GabrielFlau132/nightmare-grimm-esp32-led-robot/Models/bravo-Feliz.png

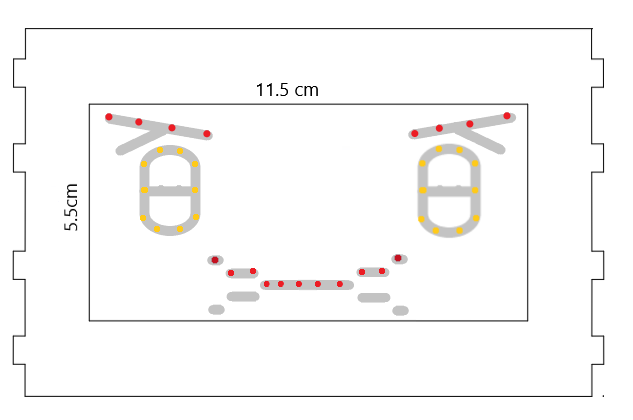
Models/bravo-Feliz.png
