GabrielFlau132/nightmare-grimm-esp32-led-robot/docs/leds.csv

led | grupo | nome_grupo | cor | pino_esp32 | resistor_do_pino_ohm | x_mm | y_mm
L01 | 1 | OLHOS_ANEL | amarelo | 25 | 100 | 14.75 | 16.00
L02 | 1 | OLHOS_ANEL | amarelo | 25 | 100 | 20.25 | 16.00
L03 | 1 | OLHOS_ANEL | amarelo | 13 | 100 | 94.75 | 16.00
L04 | 1 | OLHOS_ANEL | amarelo | 13 | 100 | 100.25 | 16.00
L05 | 1 | OLHOS_ANEL | amarelo | 25 | 100 | 9.25 | 19.25
L06 | 1 | OLHOS_ANEL | amarelo | 25 | 100 | 25.75 | 19.25
L07 | 1 | OLHOS_ANEL | amarelo | 13 | 100 | 89.25 | 19.25
L08 | 1 | OLHOS_ANEL | amarelo | 13 | 100 | 105.75 | 19.25
L09 | 1 | OLHOS_ANEL | amarelo | 25 | 100 | 9.25 | 31.75
L10 | 1 | OLHOS_ANEL | amarelo | 25 | 100 | 25.75 | 31.75
L11 | 1 | OLHOS_ANEL | amarelo | 13 | 100 | 89.25 | 31.75
L12 | 1 | OLHOS_ANEL | amarelo | 13 | 100 | 105.75 | 31.75
L13 | 1 | OLHOS_ANEL | amarelo | 25 | 100 | 14.75 | 35.00
L14 | 1 | OLHOS_ANEL | amarelo | 25 | 100 | 20.25 | 35.00
L15 | 1 | OLHOS_ANEL | amarelo | 13 | 100 | 94.75 | 35.00
L16 | 1 | OLHOS_ANEL | amarelo | 13 | 100 | 100.25 | 35.00
L17 | 2 | OLHOS_MEIO_LATERAL | amarelo | 26 | 200 | 9.25 | 25.50
L18 | 2 | OLHOS_MEIO_LATERAL | amarelo | 26 | 200 | 25.75 | 25.50
L19 | 2 | OLHOS_MEIO_LATERAL | amarelo | 26 | 200 | 89.25 | 25.50
L20 | 2 | OLHOS_MEIO_LATERAL | amarelo | 26 | 200 | 105.75 | 25.50
L21 | 3 | OLHOS_MEIO_CENTRO | amarelo | 27 | 200 | 14.75 | 25.50
L22 | 3 | OLHOS_MEIO_CENTRO | amarelo | 27 | 200 | 20.25 | 25.50
L23 | 3 | OLHOS_MEIO_CENTRO | amarelo | 27 | 200 | 94.75 | 25.50
L24 | 3 | OLHOS_MEIO_CENTRO | amarelo | 27 | 200 | 100.25 | 25.50
L25 | 4 | SOBRANCELHAS_BRAVAS | vermelho | 32 | 100 | 9.25 | 3.50
L26 | 4 | SOBRANCELHAS_BRAVAS | vermelho | 32 | 100 | 105.75 | 3.50
L27 | 4 | SOBRANCELHAS_BRAVAS | vermelho | 32 | 100 | 14.75 | 5.50
L28 | 4 | SOBRANCELHAS_BRAVAS | vermelho | 32 | 100 | 100.25 | 5.50
L29 | 4 | SOBRANCELHAS_BRAVAS | vermelho | 32 | 100 | 20.25 | 7.50
L30 | 4 | SOBRANCELHAS_BRAVAS | vermelho | 32 | 100 | 94.75 | 7.50
L31 | 4 | SOBRANCELHAS_BRAVAS | vermelho | 32 | 100 | 25.75 | 9.50
L32 | 4 | SOBRANCELHAS_BRAVAS | vermelho | 32 | 100 | 89.25 | 9.50
L33 | 5 | SOBRANCELHAS_TRISTES | azul | 33 | 47 | 14.75 | 10.75
L34 | 5 | SOBRANCELHAS_TRISTES | azul | 33 | 47 | 100.25 | 10.75
L35 | 5 | SOBRANCELHAS_TRISTES | azul | 33 | 47 | 9.25 | 12.75
L36 | 5 | SOBRANCELHAS_TRISTES | azul | 33 | 47 | 105.75 | 12.75
L37 | 5 | SOBRANCELHAS_TRISTES | azul | 33 | 47 | 3.75 | 14.75
L38 | 5 | SOBRANCELHAS_TRISTES | azul | 33 | 47 | 111.25 | 14.75
L39 | 6 | BOCA_RETA | vermelho | 23 | 200 | 49.62 | 40.75
L40 | 6 | BOCA_RETA | vermelho | 23 | 200 | 54.88 | 40.75
L41 | 6 | BOCA_RETA | vermelho | 23 | 200 | 60.12 | 40.75
L42 | 6 | BOCA_RETA | vermelho | 23 | 200 | 65.38 | 40.75
L43 | 7 | BOCA_SORRISO | vermelho | 19 | 150 | 34.62 | 35.75
L44 | 7 | BOCA_SORRISO | vermelho | 19 | 150 | 80.38 | 35.75
L45 | 7 | BOCA_SORRISO | vermelho | 19 | 150 | 39.12 | 38.25
L46 | 7 | BOCA_SORRISO | vermelho | 19 | 150 | 44.38 | 38.25
L47 | 7 | BOCA_SORRISO | vermelho | 19 | 150 | 70.62 | 38.25
L48 | 7 | BOCA_SORRISO | vermelho | 19 | 150 | 75.88 | 38.25
L49 | 8 | BOCA_TRISTE | azul | 18 | 47 | 49.62 | 46.00
L50 | 8 | BOCA_TRISTE | azul | 18 | 47 | 54.88 | 46.00
L51 | 8 | BOCA_TRISTE | azul | 4 | 47 | 60.12 | 46.00
L52 | 8 | BOCA_TRISTE | azul | 4 | 47 | 65.38 | 46.00
L53 | 8 | BOCA_TRISTE | azul | 18 | 47 | 39.12 | 48.50
L54 | 8 | BOCA_TRISTE | azul | 18 | 47 | 44.38 | 48.50
L55 | 8 | BOCA_TRISTE | azul | 4 | 47 | 70.62 | 48.50
L56 | 8 | BOCA_TRISTE | azul | 4 | 47 | 75.88 | 48.50
L57 | 8 | BOCA_TRISTE | azul | 18 | 47 | 34.62 | 51.00
L58 | 8 | BOCA_TRISTE | azul | 4 | 47 | 80.38 | 51.00
