GabrielFlau132/nightmare-grimm-esp32-led-robot/code/NightmareGrimm/config.h

// Configuração do Nightmare Grimm: pinos e tempos.
// É aqui que se ajusta o comportamento sem mexer na lógica.
#pragma once
#include <Arduino.h>
#include "expressoes.h"

// ---------------------------------------------------------------------------
// Pinos do ESP32 (ver grupos_led.h)
// ---------------------------------------------------------------------------
// Os LEDs são ligados direto nos pinos, sem driver: pino -> resistor -> anodo,
// catodo no GND (comum a todos). Cada pino fica com no máximo 8 LEDs (~16 mA),
// por isso os grupos grandes usam 2 pinos: o primeiro liga a metade esquerda
// do rosto (vista de frente) e o segundo, a metade direita.
//
// Escolhidos entre as saídas seguras do ESP32 DevKit: ficam de fora os pinos
// de boot (0, 2, 5, 12, 15), os da memória flash (6–11), os que só funcionam
// como entrada (34–39), a serial USB (1, 3) e o 14 (oscila no boot).
// 21 e 22 ficam livres para I2C.
constexpr uint8_t SEM_PINO = 0xFF;
constexpr uint8_t MAX_PINOS_POR_GRUPO = 2;

constexpr uint8_t PINOS_OLHOS_ANEL[MAX_PINOS_POR_GRUPO]           = { 25, 13 };
// Fios laranja (26) e amarelo (27) retirados: esses grupos só serviam para a
// barra da piscada (ver PISCADA_APAGA_OLHOS). Os pinos continuam reservados.
constexpr uint8_t PINOS_OLHOS_MEIO_LATERAL[MAX_PINOS_POR_GRUPO]   = { 26, SEM_PINO };
constexpr uint8_t PINOS_OLHOS_MEIO_CENTRO[MAX_PINOS_POR_GRUPO]    = { 27, SEM_PINO };
constexpr uint8_t PINOS_SOBRANCELHAS_BRAVAS[MAX_PINOS_POR_GRUPO]  = { 32, SEM_PINO };
constexpr uint8_t PINOS_SOBRANCELHAS_TRISTES[MAX_PINOS_POR_GRUPO] = { 33, SEM_PINO };
constexpr uint8_t PINOS_BOCA_RETA[MAX_PINOS_POR_GRUPO]            = { 23, SEM_PINO };
constexpr uint8_t PINOS_BOCA_SORRISO[MAX_PINOS_POR_GRUPO]         = { 19, SEM_PINO };
constexpr uint8_t PINOS_BOCA_TRISTE[MAX_PINOS_POR_GRUPO]          = { 18, 4 };

// Nível do pino que ACENDE os LEDs.
//   HIGH: LED entre o pino e o GND (o pino fornece a corrente). É a ligação
//         do README.
//   LOW:  LED entre o 3V3 e o pino (o pino absorve a corrente).
constexpr uint8_t NIVEL_LED_ACESO = HIGH;

// ---------------------------------------------------------------------------
// Expressões
// ---------------------------------------------------------------------------
constexpr Expressao EXPRESSAO_INICIAL = Expressao::NEUTRO;

// Modo demonstração: troca de expressão sozinho, em ordem, até receber um
// comando de expressão (pela serial ou pelo celular).
constexpr bool     DEMO_AO_LIGAR     = true;
constexpr uint32_t DEMO_INTERVALO_MS = 5000;

// ---------------------------------------------------------------------------
// Piscada
// ---------------------------------------------------------------------------
constexpr bool PISCADA_ATIVA = true;

// Como fica o olho fechado:
//   true:  olhos apagados (sem os fios laranja e amarelo).
//   false: só a barra do meio acesa (precisa dos fios laranja e amarelo).
constexpr bool PISCADA_APAGA_OLHOS = true;

// O tempo até a próxima piscada é sorteado entre o mínimo e o máximo.
constexpr uint32_t PISCADA_INTERVALO_MIN_MS = 2500;
constexpr uint32_t PISCADA_INTERVALO_MAX_MS = 6000;
constexpr uint32_t PISCADA_FECHADO_MS       = 80;   // olhos fechados em cada piscada

// Piscada dupla: chance (0–100 %) de piscar de novo logo em seguida.
constexpr uint8_t  PISCADA_DUPLA_CHANCE     = 20;
constexpr uint32_t PISCADA_DUPLA_PAUSA_MS   = 100;  // olhos abertos entre as duas

static_assert(PISCADA_INTERVALO_MIN_MS <= PISCADA_INTERVALO_MAX_MS,
              "PISCADA_INTERVALO_MIN_MS deve ser <= PISCADA_INTERVALO_MAX_MS");
static_assert(PISCADA_DUPLA_CHANCE <= 100, "PISCADA_DUPLA_CHANCE é uma porcentagem");

// ---------------------------------------------------------------------------
// Buzzers (música)
// ---------------------------------------------------------------------------
// 5 buzzers passivos, um por voz da música: positivo no GPIO, negativo no GND.
// Mesmos pinos da versão anterior (TroupeMasterGrimm_ESP32_Basico.ino).
constexpr uint8_t TOTAL_BUZZERS = 5;
constexpr uint8_t PINOS_BUZZERS[TOTAL_BUZZERS] = { 16, 17, 21, 22, 14 };

// Um canal LEDC por buzzer. Neste ESP32 o timer do canal é (canal / 2) % 4 em
// cada grupo de 8 canais, então 0, 2, 4, 6 e 8 usam 5 timers diferentes e cada
// buzzer pode ter a própria frequência.
constexpr uint8_t CANAIS_BUZZERS[TOTAL_BUZZERS] = { 0, 2, 4, 6, 8 };

// Ajuste da música para buzzer piezo, que soa mal e alto demais nos graves.
// Subir de oitava mantém a nota (Ré continua Ré), então a harmonia não muda.
constexpr uint8_t  MUSICA_OITAVAS_ACIMA  = 1;    // sobe a música toda (0 = original)
constexpr uint16_t MUSICA_FREQ_MINIMA_HZ = 523;  // notas abaixo disso sobem até chegar aqui
constexpr uint8_t  MUSICA_VOLUME_GRAVES  = 35;   // % do volume dessas notas (100 = igual às outras)

static_assert(MUSICA_VOLUME_GRAVES <= 100, "MUSICA_VOLUME_GRAVES é uma porcentagem");

// ---------------------------------------------------------------------------
// Controle pelo celular (Wi-Fi)
// ---------------------------------------------------------------------------
// O ESP32 cria esta rede. Conecte o celular nela e abra http://192.168.4.1
constexpr char WIFI_NOME[]  = "NightmareGrimm";
constexpr char WIFI_SENHA[] = "grimm1234";

static_assert(sizeof(WIFI_SENHA) - 1 >= 8, "WIFI_SENHA precisa de pelo menos 8 caracteres");

// ---------------------------------------------------------------------------
// Serial e teste de montagem
// ---------------------------------------------------------------------------
constexpr uint32_t SERIAL_VELOCIDADE = 115200;
constexpr uint32_t TESTE_GRUPO_MS    = 1500;  // tempo aceso de cada grupo no teste
