GabrielFlau132/nightmare-grimm-esp32-led-robot/code/TroupeMasterGrimm_ESP32_Basico.ino

// Troupe Master Grimm - ESP32 com 5 buzzers passivos
// Pinos usados: GPIO 16, 17, 21, 22 e 14
// Buzzer positivo no GPIO; negativo no GND.
// Para ESP32 classico com Arduino-ESP32 e suporte a tone()/noTone().

#include <Arduino.h>

const uint8_t BUZZER_PINS[5] = {16, 17, 21, 22, 14};

struct NoteEvent {
  uint32_t startMs;
  uint16_t durationMs;
  uint16_t frequency;
  uint8_t voice;
};

const NoteEvent events[] = {
  {0UL, 213, 587, 0},
  {0UL, 213, 440, 1},
  {0UL, 213, 294, 2},
  {0UL, 213, 73, 3},
  {0UL, 213, 147, 4},
  {214UL, 203, 220, 0},
  {214UL, 203, 147, 1},
  {429UL, 202, 277, 0},
  {429UL, 202, 147, 1},
  {643UL, 203, 294, 0},
  {643UL, 203, 147, 1},
  {857UL, 203, 330, 0},
  {857UL, 203, 147, 1},
  {1071UL, 203, 220, 0},
  {1071UL, 203, 147, 1},
  {1286UL, 202, 294, 0},
  {1286UL, 202, 147, 1},
  {1500UL, 203, 330, 0},
  {1500UL, 203, 147, 1},
  {1714UL, 203, 349, 0},
  {1714UL, 203, 147, 1},
  {1929UL, 202, 220, 0},
  {1929UL, 202, 147, 1},
  {2143UL, 203, 294, 0},
  {2143UL, 203, 147, 1},
  {2357UL, 203, 349, 0},
  {2357UL, 203, 147, 1},
  {2571UL, 203, 330, 0},
  {2571UL, 203, 147, 1},
  {2786UL, 106, 220, 0},
  {2786UL, 106, 110, 1},
  {3000UL, 106, 247, 0},
  {3000UL, 106, 123, 1},
  {3214UL, 107, 277, 0},
  {3214UL, 107, 139, 1},
  {3429UL, 202, 294, 0},
  {3429UL, 202, 147, 1},
  {3643UL, 203, 220, 0},
  {3643UL, 203, 147, 1},
  {3857UL, 203, 277, 0},
  {3857UL, 203, 147, 1},
  {4071UL, 203, 294, 0},
  {4071UL, 203, 147, 1},
  {4286UL, 202, 330, 0},
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
  {123428UL, 1628, 932, 0},
  {123428UL, 1628, 698, 1},
  {123428UL, 1628, 554, 2},
  {123428UL, 1628, 466, 3},
  {123428UL, 1221, 69, 4},
  {124714UL, 406, 78, 4},
  {125143UL, 813, 698, 0},
  {125143UL, 813, 554, 1},
  {125143UL, 813, 466, 2},
  {125143UL, 813, 349, 3},
  {125143UL, 813, 87, 4},
  {126000UL, 813, 554, 0},
  {126000UL, 813, 466, 1},
  {126000UL, 813, 370, 2},
  {126000UL, 813, 277, 3},
  {126000UL, 406, 92, 4},
  {126428UL, 407, 104, 4},
  {126857UL, 1628, 554, 0},
  {126857UL, 1628, 440, 1},
  {126857UL, 1628, 349, 2},
  {126857UL, 1628, 110, 3},
  {128571UL, 1628, 554, 0},
  {128571UL, 1628, 440, 1},
  {128571UL, 1628, 392, 2},
  {128571UL, 1628, 330, 3},
  {128571UL, 1628, 110, 4},
  {130286UL, 213, 587, 0},
  {130286UL, 213, 440, 1},
  {130286UL, 213, 294, 2},
  {130286UL, 213, 73, 3},
  {130286UL, 213, 147, 4},
};

const uint16_t EVENT_COUNT = sizeof(events) / sizeof(events[0]);
uint32_t voiceEnd[5] = {0, 0, 0, 0, 0};
uint16_t nextEvent = 0;
uint32_t playbackStart = 0;
bool finished = false;

void setVoiceFrequency(uint8_t voice, uint16_t frequency) {
  if (frequency == 0) noTone(BUZZER_PINS[voice]);
  else tone(BUZZER_PINS[voice], frequency);
}

void setup() {
  Serial.begin(115200);
  for (uint8_t i = 0; i < 5; i++) {
    pinMode(BUZZER_PINS[i], OUTPUT);
    noTone(BUZZER_PINS[i]);
  }
  playbackStart = millis();
  Serial.println("Troupe Master Grimm - 5 buzzers");
}

void loop() {
  if (finished) return;

  uint32_t now = millis() - playbackStart;

  for (uint8_t i = 0; i < 5; i++) {
    if (voiceEnd[i] != 0 && (int32_t)(now - voiceEnd[i]) >= 0) {
      setVoiceFrequency(i, 0);
      voiceEnd[i] = 0;
    }
  }

  while (nextEvent < EVENT_COUNT) {
    const NoteEvent &e = events[nextEvent];
    if (e.startMs > now) break;
    nextEvent++;

    uint32_t eventEnd = e.startMs + e.durationMs;
    if ((int32_t)(eventEnd - now) <= 0) continue;

    setVoiceFrequency(e.voice, e.frequency);
    voiceEnd[e.voice] = eventEnd;
  }

  if (nextEvent >= EVENT_COUNT) {
    bool playing = false;
    for (uint8_t i = 0; i < 5; i++) {
      if (voiceEnd[i] != 0) playing = true;
    }
    if (!playing) {
      finished = true;
      Serial.println("Reproducao finalizada");
    }
  }
}
