GabrielFlau132/nightmare-grimm-esp32-led-robot/code/NightmareGrimm/musica_giornos_theme.h

// Il vento d'oro (Giorno's Theme), em 5 vozes, para os 5 buzzers.
// Gerado por ferramentas/midi_para_buzzer.py a partir de giornos-theme-il-vento-doro-jojos-bizarre-adventure-golden-wind-ost.mid.
// 2854 notas, 289.5 s. Cada evento: {início ms, duração ms, frequência Hz, voz}.
#pragma once
#include "musica_eventos.h"

const EventoNota GIORNOS_THEME[] = {
  {0UL, 210, 123, 0},
  {222UL, 210, 123, 0},
  {444UL, 100, 123, 0},
  {556UL, 210, 110, 0},
  {778UL, 210, 123, 0},
  {1000UL, 210, 147, 0},
  {1222UL, 210, 123, 0},
  {1444UL, 100, 92, 0},
  {1556UL, 210, 110, 0},
  {1778UL, 210, 123, 0},
  {2000UL, 210, 123, 0},
  {2222UL, 99, 123, 0},
  {2333UL, 211, 110, 0},
  {2556UL, 210, 123, 0},
  {2778UL, 210, 175, 0},
  {3000UL, 210, 165, 0},
  {3222UL, 99, 147, 0},
  {3333UL, 211, 110, 0},
  {3556UL, 210, 123, 0},
  {3778UL, 210, 123, 0},
  {4000UL, 99, 123, 0},
  {4111UL, 210, 110, 0},
  {4333UL, 211, 123, 0},
  {4556UL, 210, 147, 0},
  {4778UL, 210, 123, 0},
  {5000UL, 99, 92, 0},
  {5111UL, 210, 110, 0},
  {5333UL, 211, 123, 0},
  {5556UL, 210, 123, 0},
  {5778UL, 99, 123, 0},
  {5889UL, 99, 110, 0},
  {6000UL, 99, 123, 0},
  {6111UL, 210, 147, 0},
  {6333UL, 211, 175, 0},
  {6556UL, 210, 165, 0},
  {6778UL, 99, 147, 0},
  {6889UL, 210, 110, 0},
  {7111UL, 210, 247, 0},
  {7111UL, 210, 123, 1},
  {7333UL, 211, 247, 0},
  {7333UL, 211, 123, 1},
  {7556UL, 99, 247, 0},
  {7556UL, 99, 123, 1},
  {7667UL, 210, 220, 0},
  {7667UL, 210, 110, 1},
  {7889UL, 210, 247, 0},
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
  {280333UL, 210, 247, 1},
  {280333UL, 210, 123, 2},
  {280333UL, 210, 62, 3},
  {280555UL, 99, 370, 0},
  {280555UL, 99, 185, 1},
  {280555UL, 316, 123, 2},
  {280555UL, 316, 62, 3},
  {280666UL, 211, 440, 0},
  {280666UL, 211, 220, 1},
  {280889UL, 210, 494, 0},
  {280889UL, 210, 247, 1},
  {280889UL, 210, 123, 2},
  {280889UL, 210, 62, 3},
  {281111UL, 210, 494, 0},
  {281111UL, 210, 247, 1},
  {281111UL, 210, 123, 2},
  {281111UL, 210, 62, 3},
  {281333UL, 99, 494, 0},
  {281333UL, 99, 247, 1},
  {281333UL, 316, 123, 2},
  {281333UL, 316, 62, 3},
  {281444UL, 99, 440, 0},
  {281444UL, 99, 220, 1},
  {281555UL, 99, 494, 0},
  {281555UL, 99, 247, 1},
  {281666UL, 211, 587, 0},
  {281666UL, 211, 294, 1},
  {281666UL, 211, 123, 2},
  {281666UL, 211, 62, 3},
  {281889UL, 210, 698, 0},
  {281889UL, 210, 349, 1},
  {281889UL, 210, 123, 2},
  {281889UL, 210, 62, 3},
  {282111UL, 210, 659, 0},
  {282111UL, 210, 330, 1},
  {282111UL, 210, 123, 2},
  {282111UL, 210, 62, 3},
  {282333UL, 99, 587, 0},
  {282333UL, 99, 294, 1},
  {282333UL, 316, 123, 2},
  {282333UL, 316, 62, 3},
  {282444UL, 210, 440, 0},
  {282444UL, 210, 220, 1},
  {283555UL, 5910, 554, 0},
  {283555UL, 5910, 440, 1},
  {283555UL, 5910, 62, 2},
  {283555UL, 5910, 277, 3},
  {283555UL, 5910, 123, 4},
};
