GabrielFlau132/nightmare-grimm-esp32-led-robot/code/NightmareGrimm/musica_giornos_theme_reduzida.h

// Il vento d'oro (versão reduzida), em 5 vozes, para os 5 buzzers.
// Gerado por ferramentas/midi_para_buzzer.py a partir de JOJOreduzida.mid.
// 361 notas, 28.7 s. Cada evento: {início ms, duração ms, frequência Hz, voz}.
#pragma once
#include "musica_eventos.h"

const EventoNota GIORNOS_THEME_REDUZIDA[] = {
  {0UL, 628, 740, 0},
  {0UL, 628, 587, 1},
  {0UL, 628, 247, 2},
  {0UL, 628, 123, 3},
  {662UL, 837, 587, 0},
  {662UL, 837, 494, 1},
  {662UL, 1047, 208, 2},
  {662UL, 1047, 104, 3},
  {1544UL, 98, 587, 0},
  {1654UL, 99, 659, 0},
  {1765UL, 313, 698, 0},
  {1765UL, 313, 554, 1},
  {1765UL, 837, 277, 2},
  {1765UL, 837, 139, 3},
  {2096UL, 313, 659, 0},
  {2426UL, 209, 587, 0},
  {2647UL, 313, 554, 0},
  {2647UL, 313, 466, 1},
  {2647UL, 837, 185, 2},
  {2647UL, 837, 92, 3},
  {2978UL, 313, 587, 0},
  {3309UL, 208, 659, 0},
  {3529UL, 628, 740, 0},
  {3529UL, 628, 587, 1},
  {3529UL, 628, 247, 2},
  {3529UL, 628, 123, 3},
  {4191UL, 628, 988, 0},
  {4191UL, 628, 587, 1},
  {4191UL, 1047, 208, 2},
  {4191UL, 1047, 104, 3},
  {4853UL, 209, 494, 0},
  {5074UL, 208, 554, 0},
  {5294UL, 314, 587, 0},
  {5294UL, 314, 494, 1},
  {5294UL, 837, 277, 2},
  {5294UL, 98, 139, 3},
  {5404UL, 221, 139, 3},
  {5625UL, 313, 659, 0},
  {5625UL, 98, 139, 1},
  {5735UL, 209, 139, 1},
  {5956UL, 208, 587, 0},
  {5956UL, 208, 139, 1},
  {6176UL, 314, 554, 0},
  {6176UL, 314, 466, 1},
  {6176UL, 838, 185, 2},
  {6176UL, 99, 92, 3},
  {6287UL, 220, 92, 3},
  {6507UL, 314, 880, 0},
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
  {26801UL, 99, 139, 2},
  {26801UL, 99, 69, 3},
  {26912UL, 208, 139, 2},
  {26912UL, 208, 69, 3},
  {27132UL, 209, 1480, 0},
  {27132UL, 209, 740, 1},
  {27132UL, 209, 139, 2},
  {27132UL, 209, 69, 3},
  {27353UL, 313, 1397, 0},
  {27353UL, 313, 1109, 1},
  {27353UL, 313, 698, 2},
  {27353UL, 98, 92, 3},
  {27353UL, 98, 46, 4},
  {27463UL, 209, 92, 3},
  {27463UL, 221, 46, 4},
  {27684UL, 313, 2349, 0},
  {27684UL, 313, 1175, 1},
  {27684UL, 98, 92, 2},
  {27684UL, 98, 46, 3},
  {27794UL, 209, 92, 2},
  {27794UL, 209, 46, 3},
  {28015UL, 208, 1865, 0},
  {28015UL, 208, 932, 1},
  {28015UL, 208, 92, 2},
  {28015UL, 208, 46, 3},
  {28235UL, 418, 1976, 0},
  {28235UL, 418, 1480, 1},
  {28235UL, 418, 988, 2},
  {28235UL, 418, 123, 3},
  {28235UL, 418, 62, 4},
};
