GabrielFlau132/nightmare-grimm-esp32-led-robot/code/NightmareGrimm/musica_tetris.h

// Tetris (Korobeiniki), em 5 vozes, para os 5 buzzers.
// Gerado por ferramentas/midi_para_buzzer.py a partir de tetris-theme.mid.
// 827 notas, 96.4 s. Cada evento: {início ms, duração ms, frequência Hz, voz}.
#pragma once
#include "musica_eventos.h"

const EventoNota TETRIS[] = {
  {0UL, 406, 659, 0},
  {0UL, 406, 494, 1},
  {429UL, 406, 659, 0},
  {429UL, 202, 82, 1},
  {643UL, 202, 165, 1},
  {857UL, 202, 494, 0},
  {857UL, 202, 415, 1},
  {857UL, 203, 82, 2},
  {1071UL, 203, 523, 0},
  {1071UL, 203, 165, 1},
  {1286UL, 202, 587, 0},
  {1286UL, 202, 82, 1},
  {1500UL, 95, 659, 0},
  {1500UL, 202, 165, 1},
  {1607UL, 95, 587, 0},
  {1714UL, 203, 523, 0},
  {1714UL, 203, 440, 1},
  {1714UL, 203, 82, 2},
  {1929UL, 202, 494, 0},
  {1929UL, 202, 415, 1},
  {1929UL, 202, 165, 2},
  {2143UL, 406, 440, 0},
  {2143UL, 406, 330, 1},
  {2143UL, 202, 55, 2},
  {2357UL, 203, 110, 2},
  {2571UL, 203, 440, 0},
  {2571UL, 203, 55, 1},
  {2786UL, 202, 523, 0},
  {2786UL, 202, 110, 1},
  {3000UL, 406, 659, 0},
  {3000UL, 202, 55, 1},
  {3214UL, 203, 110, 1},
  {3429UL, 202, 587, 0},
  {3429UL, 202, 55, 1},
  {3643UL, 202, 523, 0},
  {3643UL, 202, 110, 1},
  {3857UL, 406, 494, 0},
  {3857UL, 406, 415, 1},
  {3857UL, 202, 52, 2},
  {4071UL, 203, 104, 2},
  {4286UL, 202, 494, 0},
  {4286UL, 202, 415, 1},
  {4286UL, 202, 52, 2},
  {4500UL, 202, 523, 0},
  {4500UL, 202, 440, 1},
  {4500UL, 202, 104, 2},
  {4714UL, 407, 587, 0},
  {4714UL, 407, 494, 1},
  {4714UL, 203, 52, 2},
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
  {92357UL, 203, 131, 2},
  {92572UL, 202, 587, 0},
  {92572UL, 202, 349, 1},
  {92572UL, 202, 65, 2},
  {92786UL, 202, 523, 0},
  {92786UL, 202, 330, 1},
  {92786UL, 202, 131, 2},
  {93000UL, 406, 494, 0},
  {93000UL, 406, 415, 1},
  {93000UL, 202, 82, 2},
  {93214UL, 203, 165, 2},
  {93429UL, 202, 494, 0},
  {93429UL, 202, 415, 1},
  {93429UL, 202, 82, 2},
  {93643UL, 202, 523, 0},
  {93643UL, 202, 440, 1},
  {93643UL, 202, 165, 2},
  {93857UL, 407, 587, 0},
  {93857UL, 407, 494, 1},
  {93857UL, 203, 82, 2},
  {94072UL, 202, 165, 2},
  {94286UL, 406, 659, 0},
  {94286UL, 202, 82, 1},
  {94500UL, 202, 165, 1},
  {94714UL, 407, 523, 0},
  {94714UL, 203, 110, 1},
  {94929UL, 202, 220, 1},
  {95143UL, 406, 440, 0},
  {95143UL, 202, 110, 1},
  {95357UL, 203, 220, 1},
  {95572UL, 406, 440, 0},
  {95572UL, 202, 110, 1},
  {95786UL, 203, 220, 1},
  {96000UL, 202, 110, 0},
  {96214UL, 203, 220, 0},
};
