GabrielFlau132/nightmare-grimm-esp32-led-robot/code/NightmareGrimm/musica_winner_takes_it_all.h

// The Winner Takes It All (versão Breeze Piano), em 5 vozes, para os 5 buzzers.
// Gerado por ferramentas/midi_para_buzzer.py a partir de the-winner-takes-it-all-by-abba-breezepiano.mid.
// 2305 notas, 302.1 s. Cada evento: {início ms, duração ms, frequência Hz, voz}.
#pragma once
#include "musica_eventos.h"

const EventoNota WINNER_TAKES_IT_ALL[] = {
  {0UL, 236, 277, 0},
  {250UL, 236, 185, 0},
  {500UL, 236, 494, 0},
  {500UL, 236, 277, 1},
  {750UL, 236, 370, 0},
  {1000UL, 236, 277, 0},
  {1250UL, 236, 466, 0},
  {1250UL, 236, 185, 1},
  {1500UL, 236, 277, 0},
  {1750UL, 236, 185, 0},
  {2000UL, 236, 415, 0},
  {2000UL, 236, 92, 1},
  {2250UL, 236, 139, 0},
  {2500UL, 236, 233, 0},
  {2750UL, 1448, 370, 0},
  {2750UL, 240, 147, 1},
  {3004UL, 241, 73, 1},
  {3258UL, 241, 117, 1},
  {3513UL, 240, 147, 1},
  {3767UL, 240, 117, 1},
  {4021UL, 241, 233, 1},
  {4021UL, 241, 78, 2},
  {4275UL, 241, 117, 0},
  {4530UL, 236, 415, 0},
  {4530UL, 236, 156, 1},
  {4780UL, 236, 311, 0},
  {5030UL, 236, 233, 0},
  {5280UL, 236, 370, 0},
  {5280UL, 236, 311, 1},
  {5530UL, 236, 466, 0},
  {5780UL, 236, 233, 0},
  {6030UL, 236, 349, 0},
  {6030UL, 236, 233, 1},
  {6280UL, 236, 466, 0},
  {6530UL, 236, 233, 0},
  {6780UL, 711, 311, 0},
  {7030UL, 236, 98, 1},
  {7280UL, 236, 156, 1},
  {7530UL, 236, 196, 0},
  {7780UL, 477, 156, 0},
  {8030UL, 240, 311, 1},
  {8030UL, 240, 104, 2},
  {8284UL, 240, 156, 0},
  {8538UL, 241, 554, 0},
  {8538UL, 241, 208, 1},
  {8792UL, 237, 311, 0},
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
  {293853UL, 115, 139, 3},
  {293980UL, 119, 104, 3},
  {294107UL, 115, 69, 0},
  {294234UL, 115, 932, 0},
  {294234UL, 115, 466, 1},
  {294361UL, 7725, 932, 0},
  {294361UL, 7725, 554, 1},
  {294361UL, 7725, 466, 2},
  {294361UL, 7725, 92, 3},
  {294361UL, 7725, 46, 4},
};
