GabrielFlau132/nightmare-grimm-esp32-led-robot/(commit log)

2026-10-09 Adiciona firmware ESP32 do rosto de LEDs, layout da placa e SVG de corte
    [leds.csv]
2026-10-10 Liga os LEDs direto no ESP32 via shield com GND comum e 10 resistores, e gera a folha de ligações
    [leds.csv]
2026-10-26 Ajusta o layout para LEDs de 2,7 mm e volta a placa para 115 x 55 mm
    [leds.csv]
2026-10-28 Troca as cores dos fios na folha de ligações e adiciona o nome da cor nos rótulos e na tabela
2026-10-30 Adiciona músicas nos 5 buzzers, controle pelo celular e diagnóstico do Wi-Fi
    [DiagnosticoEsp32.ino, NightmareGrimm.ino, TesteTodosLeds.ino, TroupeMasterGrimm_ESP32_Basico.ino, comandos.cpp, comandos.h, config.h, controle_wifi.cpp]
